tomgroenwoldt/kallsup-spotify-player/hardware/enclosure/out/kallsup_base_assembly.step

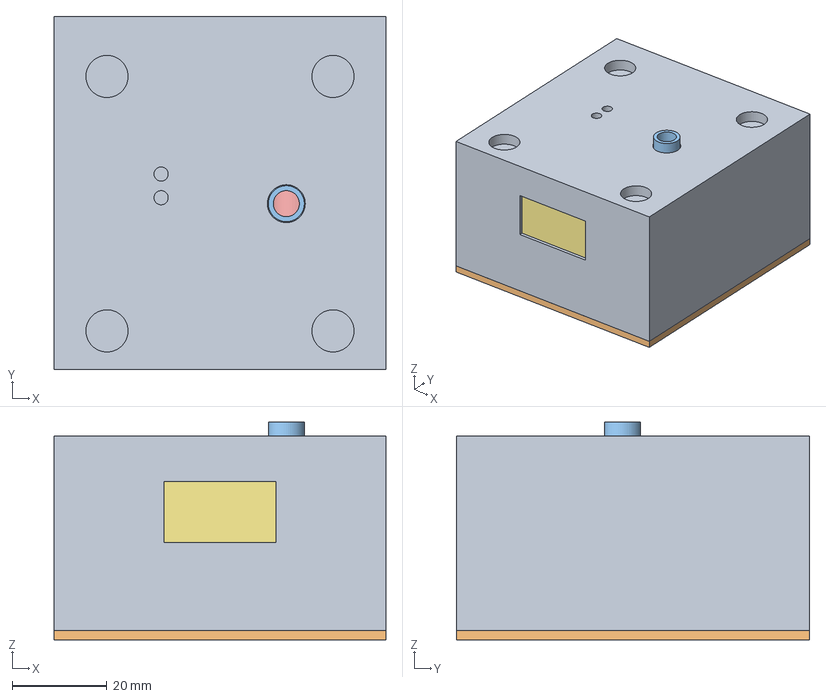
[picture p2: CAD file, 2026-10-27]
hardware/enclosure/out/kallsup_base_assembly.step
70.0 x 74.5 x 46.0 mm
plate
grommet
perfboard
header_0
header_1
devkit
module
usb_0
usb_1
button_0
button_1
led
amp
amp_terminal
cap
jst
oled_glass
oled_pcb
oled_back_parts
oled_jst
oled_plug
screw_0
screw_1
screw_2
screw_3
