tomgroenwoldt/kallsup-spotify-player/hardware/enclosure/out/plate.stl

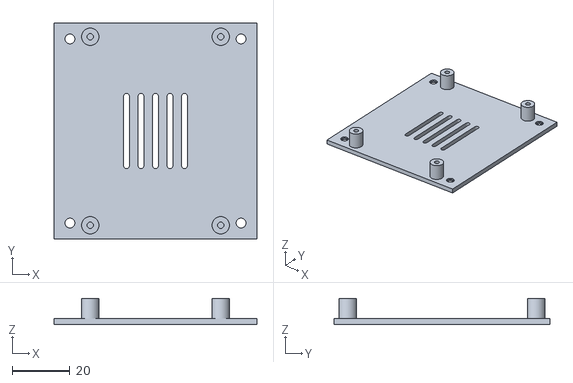
[picture p3: CAD file, 2026-10-27]
hardware/enclosure/out/plate.stl
70.0 x 74.5 x 9.00
