tomgroenwoldt/kallsup-spotify-player/hardware/enclosure/out/shell.stl

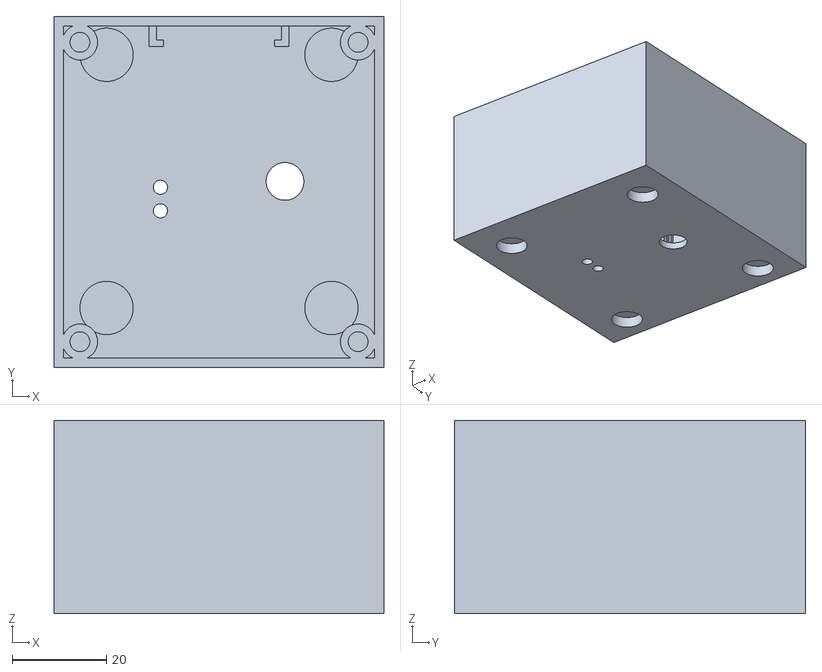
[picture p4: CAD file, 2026-10-27]
hardware/enclosure/out/shell.stl
70.0 x 74.5 x 41.0
