tomgroenwoldt/kallsup-spotify-player/hardware/enclosure/out/oled_test.stl

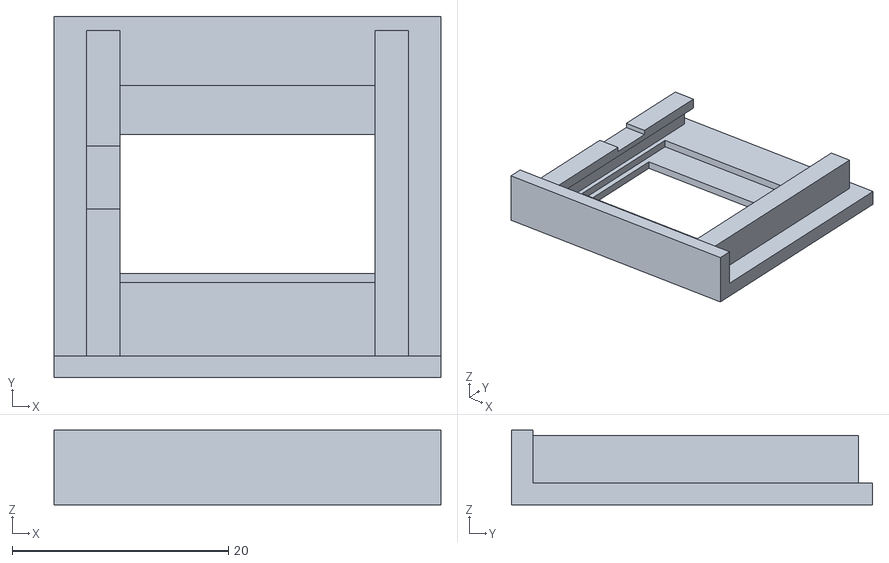
[picture p5: CAD file, 2026-10-27]
hardware/enclosure/out/oled_test.stl
35.8 x 33.4 x 6.90
