tomgroenwoldt/kallsup-spotify-player/hardware/enclosure/out/grommet.stl

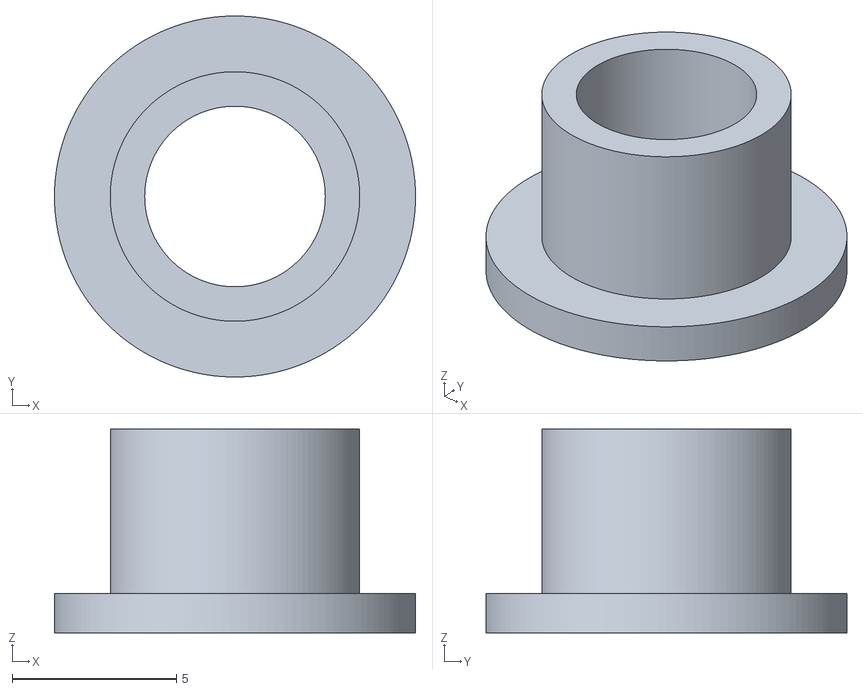
[picture p6: CAD file, 2026-10-27]
hardware/enclosure/out/grommet.stl
11.0 x 11.0 x 6.20
