tomgroenwoldt/kallsup-spotify-player/hardware/enclosure/out/lid_test.stl

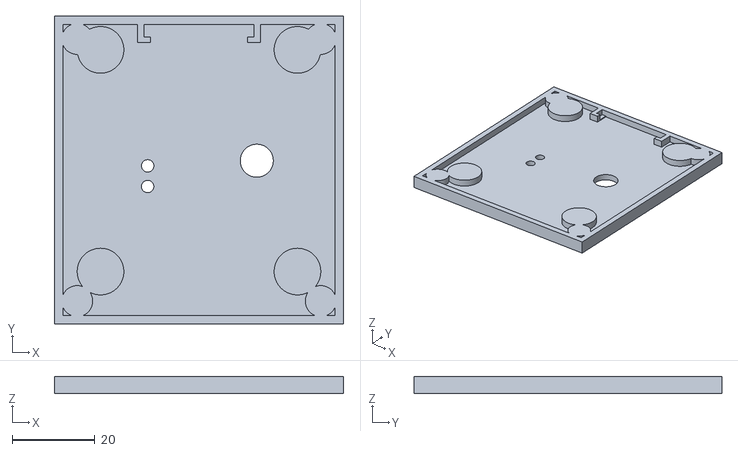
[picture p7: CAD file, 2026-10-27]
hardware/enclosure/out/lid_test.stl
70.0 x 74.5 x 4.20
