tomgroenwoldt/kallsup-spotify-player/tools/guide/anleitung.tpl.html

← Zurück zum Wecker

{{HERO}}

# Kallsup Wecker

Dein Lautsprecher weckt dich mit deinem Lieblingslied von Spotify. Einmal mit dem WLAN verbinden – danach läuft alles von selbst.

## Einrichten (nur einmal)

1. USB-Kabel hinten in den Lautsprecher stecken, Netzteil in die Steckdose. 2 Minuten warten.
  Der Wecker sucht zuerst nach einem bekannten WLAN. Findet er keins, öffnet er sein eigenes.
  {{PLUG}}
2. Handy mit dem WLAN „Kallsup-Setup“ verbinden.
  Den Code auf dem Aufkleber unter dem Wecker mit der Handy-Kamera scannen. Oder in den WLAN-Einstellungen „Kallsup-Setup“ antippen und das Passwort vom Aufkleber eingeben. Fragt das Handy wegen „kein Internet“: verbunden bleiben.
3. Die Einrichtungsseite öffnet sich von selbst.
  Wenn nicht: diesen Code scannen oder im Browser 192.168.4.1 eingeben.
  {{QR_AP}}Seite
4. Dein WLAN auswählen, Passwort eingeben, „Verbinden“ tippen.
  Nach etwa 20 Sekunden erscheint ein grünes „Verbunden!“. Bei „Passwort falsch“ einfach nochmal eingeben.
5. Handy wieder mit deinem normalen WLAN verbinden und die Wecker-Seite öffnen.
  Code scannen oder kallsup-alarm.local eingeben – am besten gleich als Lesezeichen speichern. Klappt das nicht, nimm die Zahlen-Adresse, die nach „Verbunden!“ angezeigt wurde. Mit FRITZ!Box geht auch kallsup-alarm.fritz.box.
  {{QR_HOME}}Wecker-Seite

Fertig! Das Lied und Spotify sind schon eingerichtet. Bei einem Umzug oder neuem Router einfach wieder ab Schritt 1.

## Wecker stellen

1. Wecker-Seite öffnen (kallsup-alarm.local).
2. Bei einem Wecker den Schalter einschalten, die Uhrzeit wählen und die Tage antippen.
3. „Speichern“ tippen. Oben steht dann, wann der nächste Wecker klingelt.

## Die zwei Knöpfe

{{BUTTONS}}

### Wenn der Wecker klingelt

{{SNOOZE_1}}Später nochmal wecken

{{STOP_1}}Wecker aus

### Wenn Musik läuft

Musik hören: in der Spotify-App unten auf das Lautsprecher-Symbol tippen und „Kallsup Alarm“ wählen.

{{SNOOZE_1}}Pause / weiter

{{SNOOZE_2}}Nächstes Lied

{{SNOOZE_3}}Lied zurück

{{STOP_1}}Lauter

{{STOP_2}}Leiser

{{STOP_HOLD}}Lauter, bis du loslässt

{{STOP_1_HOLD}}Leiser, bis du loslässt

2× und 3× bedeutet: schnell hintereinander drücken. Jeder Druck weckt auch die Anzeige auf, wenn sie das Gesicht zeigt.

## Das Display

Vorne am Sockel zeigt das Display die Uhrzeit, die Adresse des Weckers, das WLAN, den nächsten Wecker und das Lied, das gerade läuft.

Passiert 30 Sekunden lang nichts, erscheint ein Gesicht: Es blinzelt und schaut sich um, freut sich und wippt mit, wenn Musik läuft, und schläft nachts. Ein Knopfdruck oder ein neues Lied holt die Anzeige zurück. Klingelt der Wecker oder fehlen WLAN oder Uhrzeit, bleibt die Anzeige stehen.

Auf der Wecker-Seite unter „Display“: Helligkeit, Gesicht ein oder aus, nach wie vielen Sekunden, wann es schläft, und „Display einschalten“, um es ganz auszuschalten.

## Probleme?

Fast immer hilft: Stecker ziehen, 10 Sekunden warten, wieder einstecken, 2 Minuten warten.

Es piept statt Musik | Spotify oder das Internet war gerade nicht erreichbar. Der Piepton ist Absicht, damit du trotzdem wach wirst.
Wecker-Seite zeigt „Kein WLAN“ | Router an? Sonst nochmal einrichten (Seite 1). Ohne WLAN klingelt der Wecker nicht.
Wecker-Seite öffnet nicht | Ist das Handy im selben WLAN wie der Wecker? Die Zahlen-Adresse aus Schritt 5 probieren.
Zu laut oder zu leise | Auf der Wecker-Seite bei „Weckerlautstärke“ einstellen.

Klappt es trotzdem nicht, melde dich bei der Person, die dir den Wecker eingerichtet hat.

Drucken
