tomgroenwoldt/kallsup-spotify-player/firmware/main/net.h

#pragma once
// Wi-Fi (STA + fallback AP), SNTP, mDNS.
//
// Connects as a station with the credentials from settings. If none are stored,
// or there is no connection for 60 s, a setup AP is started next to the
// station, with a captive DNS so phones open the setup page by themselves. It
// stops 60 s after the station gets an IP, so the setup page can show that.
// The setup AP uses WPA2 with a random per-device password (on a sticker under
// the clock): the web API has no login, so the AP mustn't be open to anyone.

#include <string>

#include "esp_err.h"

namespace net {

constexpr const char *HOSTNAME = "kallsup-alarm";  // kallsup-alarm.local
constexpr const char *AP_SSID = "Kallsup-Setup";
constexpr size_t AP_PASS_LEN = 10;

enum class WifiError { NONE, WRONG_PASSWORD, NOT_FOUND, OTHER };

struct Status {
    bool sta_connected = false;
    bool ap_active = false;
    std::string ssid;
    std::string ip;
    int rssi = 0;
    WifiError error = WifiError::NONE;  // why the last connection attempt failed
};

esp_err_t init();

// Reconnects with the Wi-Fi credentials currently stored in settings.
// Saving new credentials, time zone or device name applies them automatically.
void reconnect();

// Applies the POSIX TZ string stored in settings.
void apply_time_zone();

Status status();

// True once SNTP has set the clock since boot.
bool time_synced();

// The setup AP's WPA2 password, AP_PASS_LEN characters.
const char *setup_password();

}  // namespace net
