tomgroenwoldt/kallsup-spotify-player/(commit log)

2026-10-21 Kallsup Spotify alarm clock: firmware phases 0-7
    ESP-IDF 5.5 firmware for an ESP32-S3 N16R8 + MAX98357A that turns an IKEA
    KALLSUP speaker into an alarm clock playing a Spotify track, per PLAN.md.
    - audio_out: I2S mono output, gain ramps, click-free start/stop, beep
    patterns, 186 ms DMA reserve (writer stalls up to ~110 ms while streaming)
    - net: Wi-Fi STA with setup AP fallback and back-off, SNTP, mDNS
    - settings + web UI: NVS config, JSON API, secrets never returned, OTA
    upload with rollback confirmation
    - alarm: state machine with Spotify playback, 15 s fallback beep, snooze,
    auto-stop, daily session check, task watchdog
    - spotify_connect: cspot (philippe44 fork, pinned) as Spotify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
    [partitions.csv]
2026-10-25 Retry failed Spotify Web API connects; add `spotify check` console command
    A failed connect (DNS, TCP or TLS handshake) has sent nothing yet, so the
    Web API client now retries it up to 3 times with a short back-off; a weak
    Wi-Fi link drops one now and then. `spotify check` runs the Web API
    preparation on demand and logs the outcome.
    [console.cpp, spotify_api.cpp]
2026-10-25 Add 3D-printable base enclosure for the electronics
    The ESP32-S3 devkit doesn't fit inside the Kallsup, so the electronics
    move into a printed base (70 x 74.5 x 29 mm) the Kallsup sits on, flush
    with its front and sides. A 50 x 70 perfboard carries the devkit in
    female headers, the MAX98357A, the bulk cap and a 6-pin JST-XH; the
    harness (5V, GND, speaker, S1, S2) runs through a grommet into an 8 mm
    hole drilled in the Kallsup's bottom.
    - kallsup_base.py: parametric build123d model; writes STEP + STLs
    (shell, plate, grommet, lid_test) to out/ and checks part clearances
    - render_perfboard.py: renders out/perfboard_layout.png, a 3D view and
    an annotated top view with the wiring
    - out/: gen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
    [grommet.stl, kallsup_base_assembly.step, lid_test.stl, plate.stl, shell.stl]
2026-10-25 Fix plate screw length in the enclosure notes
    The insert holes are 5 mm deep and the head recess leaves 0.6 mm of
    plate, so M2.5x5 (not x8) screws clamp the plate without bottoming out.
    [kallsup_base.py]
2026-10-25 Use the buttons as Spotify controls outside an alarm
    Buttons now report click series (350 ms gap). While the clock is the
    active Spotify player and no alarm is ringing or snoozed:
    - Snooze: 1 click play/pause, 2 next track, 3 previous track
    - Stop: 2 clicks volume up, 3 down (1/16 steps, synced to the app);
    a single click no longer cuts ~2 s out of the stream
    Commands run on the cspot session task via a queue, since cspot
    isn't thread-safe.
    [app_main.cpp, buttons.cpp, buttons.h, spotify_connect.cpp, spotify_connect.h]
2026-10-25 Hold Stop to ramp the volume; one click up, two down
    Buttons now also report holds: HOLD after 400 ms, then REPEAT every
    200 ms until release. While Spotify plays on the clock, Stop steps the
    volume up on one click and down on two, and keeps stepping while the
    last press is held. Other holds count as one click.
    Button volume steps reach Spotify only once they pause for 0.5 s, and
    steps that change nothing are dropped: a burst of state updates while
    the button was held made Spotify move playback to the phone.
2026-10-25 German web page, printable guide and captive-portal Wi-Fi setup
    For handing the clock to a non-technical user who only connects it to
    their own Wi-Fi.
    - Web page in German: a one-line status banner (snooze/stop buttons
    while ringing), alarms with switches and 24 h hour/minute pickers,
    song, volume, button help; technical settings under "Erweitert".
    Warns about unsaved changes.
    - Wi-Fi setup: while only the setup AP is up, the page shows just a
    network picker (GET /api/wifi/scan) and password, then "Verbunden"
    with the new address, or "Passwort falsch" / "nicht gefunden" from
    the new wifi.error status field. The AP stays up 60 s after
    connecting so the result can be read.
    - Cap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
    [captive_dns.cpp, captive_dns.h, net.cpp, net.h, web_ui.cpp]
2026-10-25 README user guide with drawings; fix step numbers in the Anleitung
    - README: an English user guide (setup, alarms, buttons, problems)
    mirroring the German /anleitung, ahead of the technical "Building
    and setup" section (renamed from "Setup").
    - build_guide.py also writes the drawings as SVG files with English
    labels to docs/img/guide/, on white so they show in GitHub's dark mode.
    - Anleitung: one-line steps were shorter than their number circle;
    they now have a minimum height with the number centred.
2026-10-25 Show the perfboard layout in WIRING.md and the README
2026-10-26 Harden the web API: signed OTA, Host check, WPA2 setup hotspot
    The web API has no login, so limit what someone on the network can do:
    - OTA only accepts app images signed with ota_signing_key.pem
    (signed apps without hardware secure boot, no eFuses burned).
    - Every endpoint checks the Host header and serves only IP literals
    and the device's own names, which stops DNS rebinding.
    - The setup hotspot uses WPA2 with a random per-device password,
    kept in NVS; build_guide.py --sticker prints it with a join QR.
    - Spotify zeroconf logins are only taken while waiting to be paired.
    - The Wi-Fi scan only runs while the setup hotspot is on.
    README documents the signing key, the sticker and the p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
    [console.cpp, net.cpp, net.h, spotify_connect.cpp, web_ui.cpp, web_ui.h]
2026-10-27 Enclosure: OLED window and rails, M3 inserts, closed back
    - Front wall: window and 1 mm glass pocket for a 0.96" OLED (26 x 26 mm
    module, glass 24.7 x 17.6). It slides into two rails from the open
    side; their lips sit 3 mm behind the wall, a stop under the lid ends
    the slide and the perfboard keeps it from dropping out. The left lip
    is trimmed where the devkit's antenna end passes.
    - oled_test.stl: just that piece of front wall, for a quick fit print.
    - Base is taller (29 -> 43 mm): room for the module plus 3 mm for its
    JST connector, and 7 mm posts (was 4) for wiring under the perfboard.
    - Corner bosses take M3 heat-set inserts (6 mm long, 5 mm OD) with
    M3x6 screws through the p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
    [grommet.stl, kallsup_base_assembly.step, lid_test.stl, oled_test.stl, plate.stl, shell.stl]
2026-10-27 OLED status display with an idle face
    - display.cpp: SSD1306 over I2C (GPIO 11/12, 0x3C) with a 5x7 font,
    umlauts and scrolling lines. Shows clock, Wi-Fi bars, IP or the setup
    hotspot's password, the next alarm, and the playing track. Without a
    display on the bus the clock runs on.
    - After 30 s without interaction a face takes over: robot eyes that
    blink and glance, arched and bobbing with an equaliser while music
    plays, asleep with rising z's at night. Button presses (which still
    act), saved settings and a new track bring the info back; it stays
    while an alarm rings or Wi-Fi or time is missing.
    - Mounted with the connector at the bottom (ROTATE_180); the face and
    the divider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
    [app_main.cpp, board_pins.h, display.cpp, display.h, settings.cpp, settings.h, spotify_connect.cpp, spotify_connect.h]
